Davide-Colabella/solar-tracker/hardware/valve-controller/valves.md

# Elettrovalvole a 5 V

Lo schematico rappresenta **quattro elettrovalvole normalmente chiuse a 5 V DC**, collegate ai morsetti J2–J5. Il riferimento precedente a Bürkert 6011 a 24 V è stato rimosso in base alla correzione dell'alimentazione.

Come richiesto, non è stato selezionato né verificato un modello commerciale. Le valvole devono servire il serbatoio a gravità; i loro ingombri e i raccordi non sono definiti dal PCB.

Il [render](valve-controller-3d.png) mostra la scheda elettronica e i suoi componenti. Il modello STEP si può esportare dall'editor PCB di KiCad. Per rappresentare anche le valvole e i tubi, importare la scheda in FreeCAD e aggiungere quattro istanze del CAD del modello di valvola effettivamente utilizzato.

Le valvole non hanno footprint sulla scheda: J2–J5 rappresentano i morsetti elettrici, non la loro posizione meccanica.
