Davide-Colabella/solar-tracker/docs/assets/solar-garden-user.png

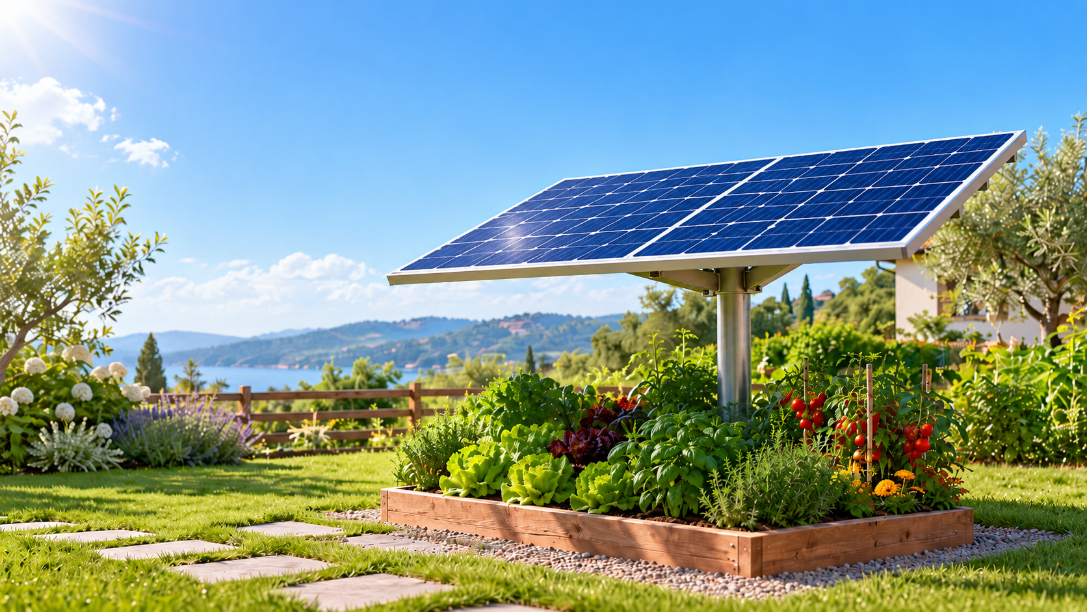
docs/assets/solar-garden-user.png
