Davide-Colabella/solar-tracker/3d models/01_Base_palo.step

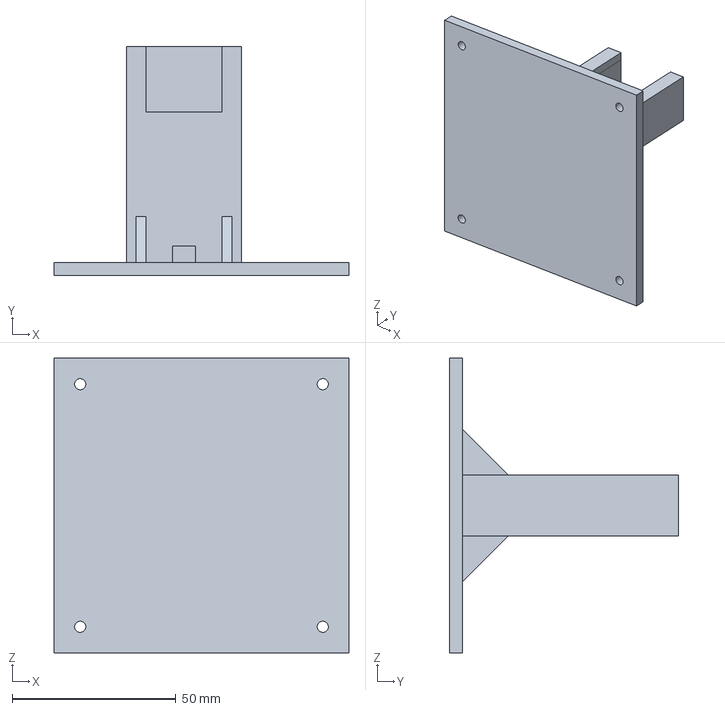
[picture p11: CAD file, 2026-10-11]
3d models/01_Base_palo.step
90.0 x 70.0 x 90.0 mm
