Davide-Colabella/solar-tracker/3d models/scatola2_led_corpo.stl

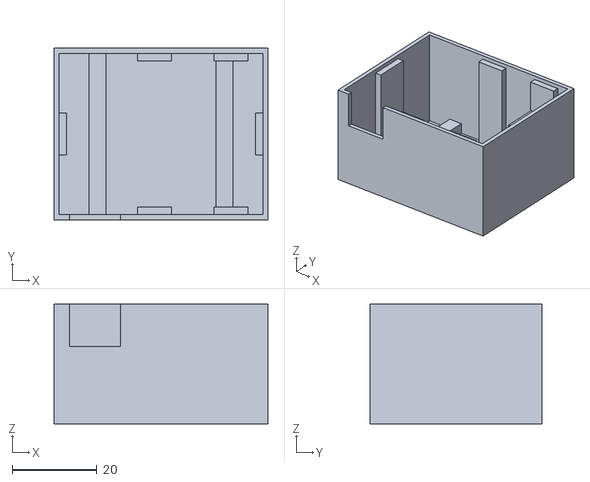
[picture p12: CAD file, 2026-10-11]
3d models/scatola2_led_corpo.stl
50.4 x 40.4 x 28.2
