Davide-Colabella/solar-tracker/3d models/scatola1_arduino_corpo.stl

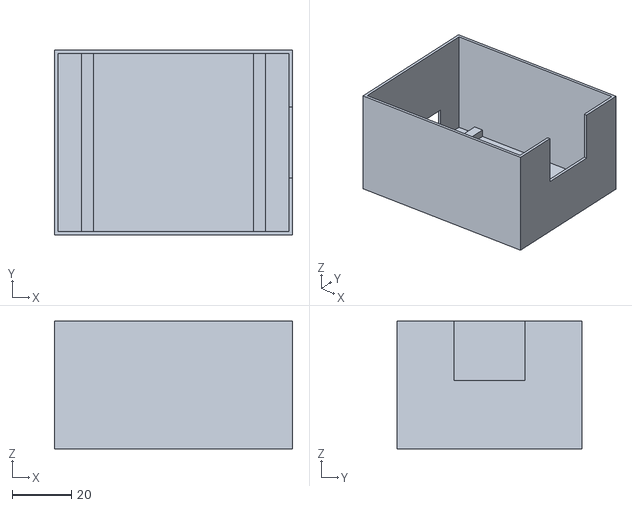
[picture p13: CAD file, 2026-10-11]
3d models/scatola1_arduino_corpo.stl
80.4 x 62.4 x 43.1
