Davide-Colabella/solar-tracker/3d models/03_Telaio_pannello_90x60.step

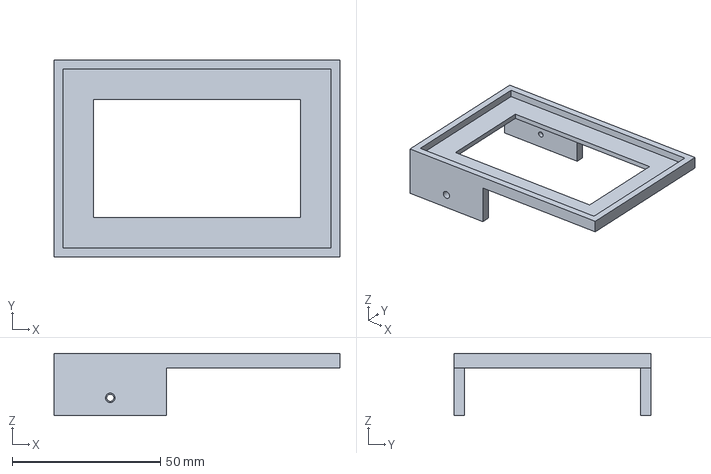
[picture p14: CAD file, 2026-10-11]
3d models/03_Telaio_pannello_90x60.step
96.6 x 66.6 x 21.0 mm
