Davide-Colabella/solar-tracker/3d models/scatola1_arduino_coperchio.stl

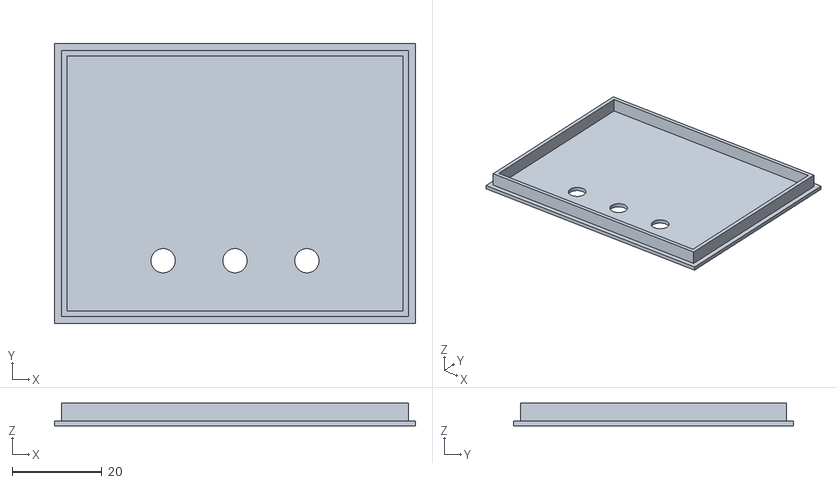
[picture p15: CAD file, 2026-10-11]
3d models/scatola1_arduino_coperchio.stl
80.4 x 62.4 x 5.12
