Davide-Colabella/solar-tracker/3d models/02_Forcella_rotante.step

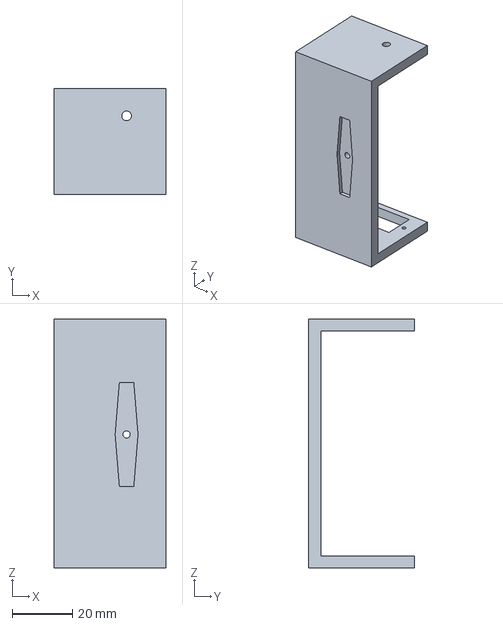
[picture p16: CAD file, 2026-10-11]
3d models/02_Forcella_rotante.step
37.0 x 35.0 x 82.6 mm
