Davide-Colabella/solar-tracker/3d models/scatola2_led_coperchio.stl

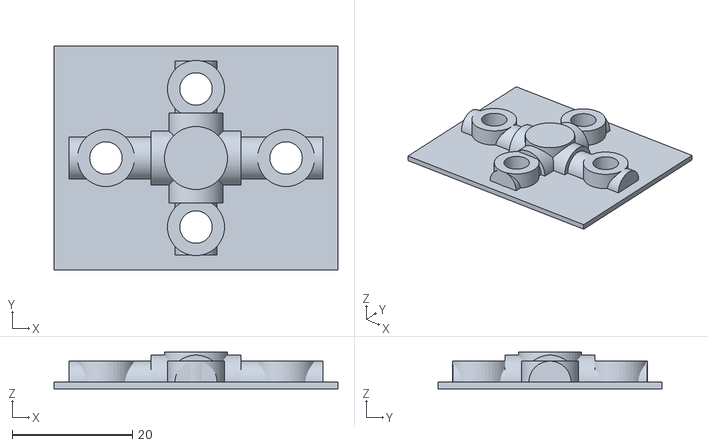
[picture p17: CAD file, 2026-10-11]
3d models/scatola2_led_coperchio.stl
47.3 x 37.3 x 6.12
