Davide-Colabella/solar-tracker/hardware/valve-controller/valve-controller.kicad_pcb

## KiCad design hardware/valve-controller/valve-controller.kicad_pcb (2026-10-11)

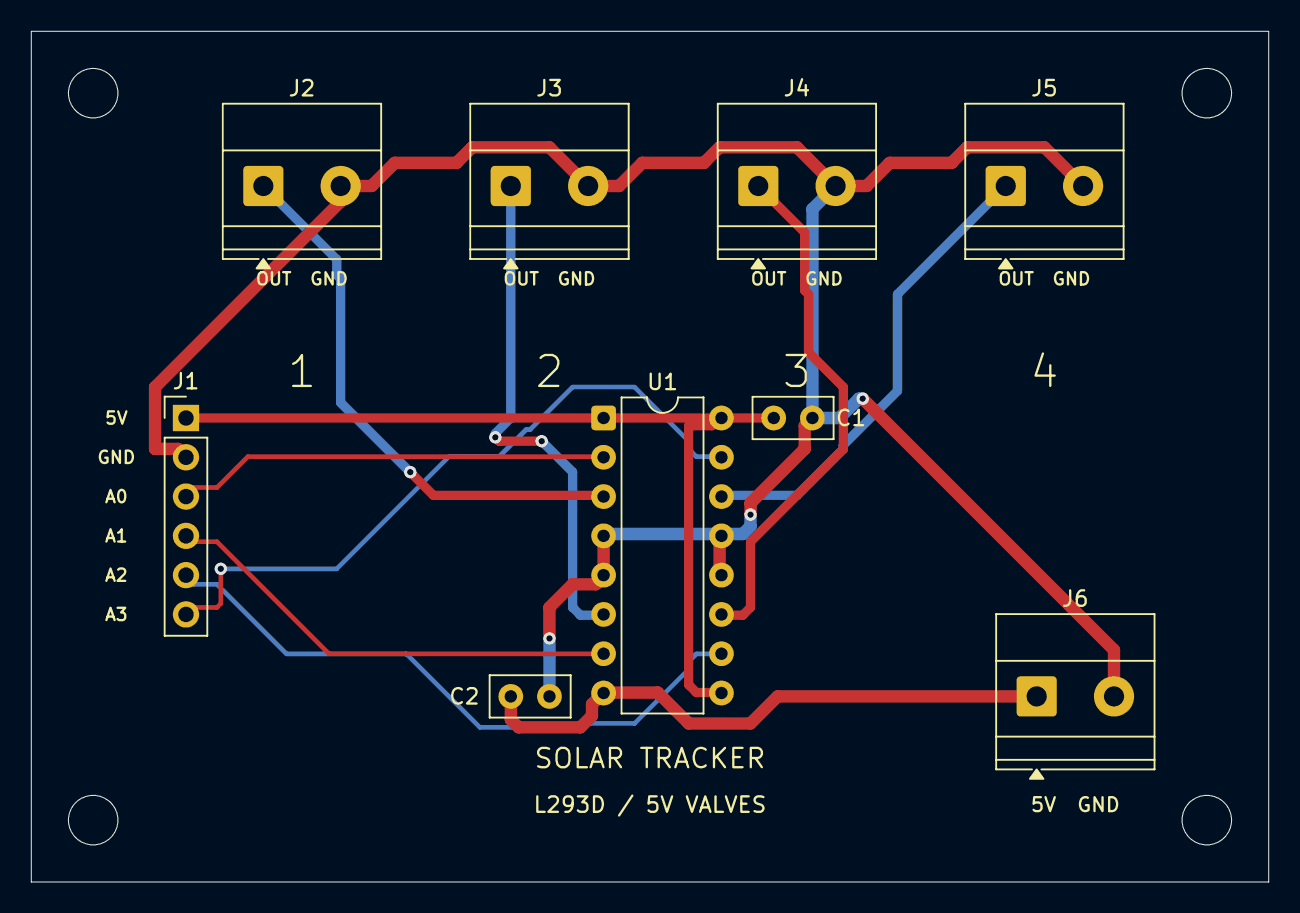
[picture p18: board valve-controller.kicad_pcb from above]

Board: 2 copper layers, 80.0 x 55.0 mm, 13 parts (0 on the bottom side), 11 nets.

Parts:
C1, C2: 100nF; C_Disc_D5.0mm_W2.5mm_P2.50mm
H1, H2, H3, H4: M3; MountingHole_3.2mm_M3
J1: UNO Q; PinHeader_1x06_P2.54mm_Vertical
J2: Valve 1; TerminalBlock_Phoenix_MKDS-1,5-2_1x02_P5.00mm_Horizontal
J3: Valve 2; TerminalBlock_Phoenix_MKDS-1,5-2_1x02_P5.00mm_Horizontal
J4: Valve 3; TerminalBlock_Phoenix_MKDS-1,5-2_1x02_P5.00mm_Horizontal
J5: Valve 4; TerminalBlock_Phoenix_MKDS-1,5-2_1x02_P5.00mm_Horizontal
J6: 5V DC input; TerminalBlock_Phoenix_MKDS-1,5-2_1x02_P5.00mm_Horizontal
U1: L293D; DIP-16_W7.62mm

Connections:
/+5V: C1.1, J1.1, U1.1, U1.9, U1.16
/+5V_VALVES: C2.1, J6.1, U1.8
/A0: J1.3, U1.2
/A1: J1.4, U1.7
/A2: J1.5, U1.10
/A3: J1.6, U1.15
/GND: C1.2, C2.2, J1.2, J2.2, J3.2, J4.2, J5.2, J6.2, U1.4, U1.5, U1.12, U1.13
/OUT1: J2.1, U1.3
/OUT2: J3.1, U1.6
/OUT3: J4.1, U1.11
/OUT4: J5.1, U1.14
