Davide-Colabella/solar-tracker/hardware/ina-panel-monitor/ina-panel-monitor.kicad_pcb

## KiCad design hardware/ina-panel-monitor/ina-panel-monitor.kicad_pcb (2026-10-11)

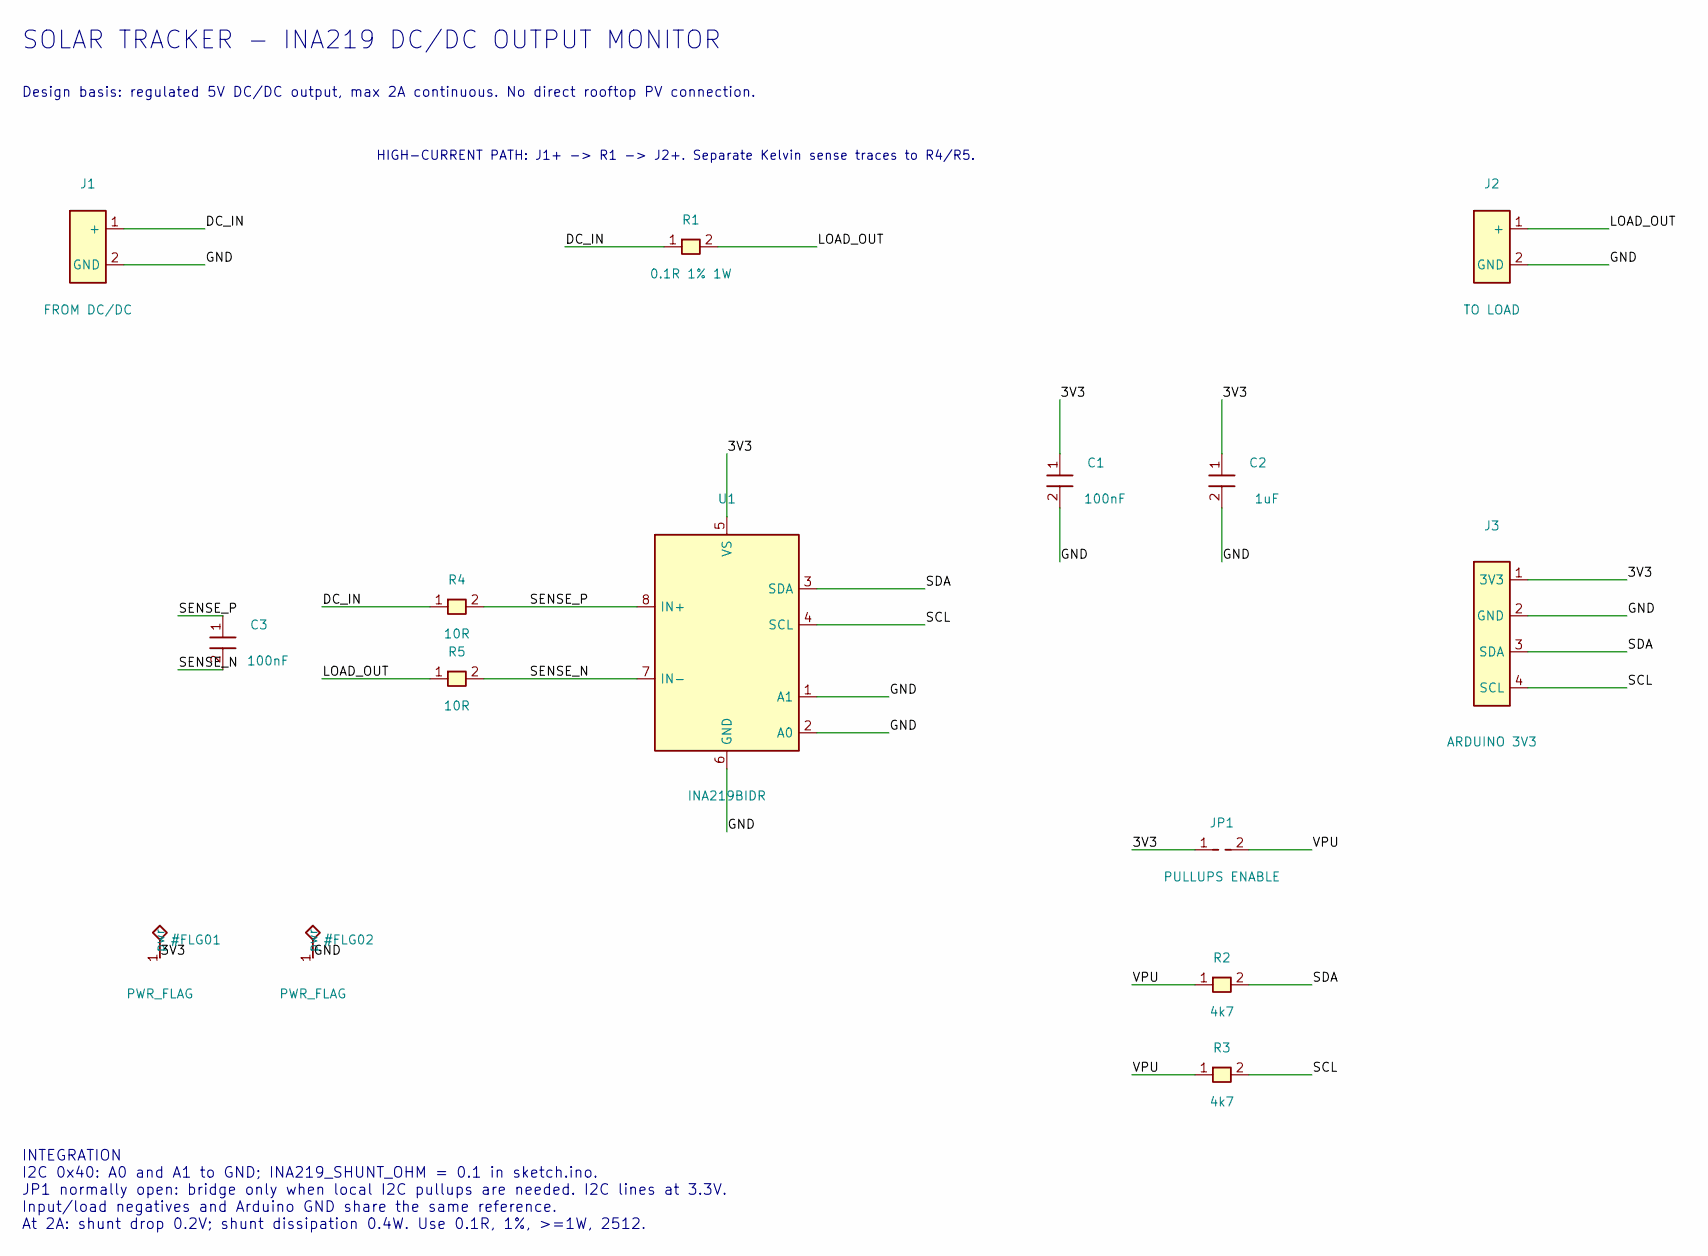
[picture p19: schematic ina-panel-monitor.kicad_sch, Solar Tracker - INA219 panel monitor]

Parts:
C1, C3: 100nF; C_0805_2012Metric
C2: 1uF; C_0805_2012Metric
J1: FROM DC/DC; TerminalBlock_Phoenix_MKDS-1,5-2_1x02_P5.00mm_Horizontal
J2: TO LOAD; TerminalBlock_Phoenix_MKDS-1,5-2_1x02_P5.00mm_Horizontal
J3: ARDUINO 3V3; PinHeader_1x04_P2.54mm_Vertical
JP1: PULLUPS ENABLE; SolderJumper-2_P1.3mm_Open_Pad1.0x1.5mm
R1: 0.1R 1% 1W; R_2512_6332Metric
R2, R3: 4k7; R_0603_1608Metric
R4, R5: 10R; R_0603_1608Metric
U1: INA219BIDR; SOIC-8_3.9x4.9mm_P1.27mm

Connections:
/3V3: C1.1, C2.1, J3.1 (3V3), JP1.1, U1.5 (VS)
/DC_IN: J1.1 (+), R1.1, R4.1
/GND: C1.2, C2.2, J1.2 (GND), J2.2 (GND), J3.2 (GND), U1.1 (A1), U1.2 (A0), U1.6 (GND)
/LOAD_OUT: J2.1 (+), R1.2, R5.1
/SCL: J3.4 (SCL), R3.2, U1.4 (SCL)
/SDA: J3.3 (SDA), R2.2, U1.3 (SDA)
/SENSE_N: C3.2, R5.2, U1.7 (IN-)
/SENSE_P: C3.1, R4.2, U1.8 (IN+)
/VPU: JP1.2, R2.1, R3.1

Notes on the sheet:
SOLAR TRACKER - INA219 DC/DC OUTPUT MONITOR
Design basis: regulated 5V DC/DC output, max 2A continuous. No direct rooftop PV connection.
HIGH-CURRENT PATH: J1+ -> R1 -> J2+. Separate Kelvin sense traces to R4/R5.
INTEGRATION I2C 0x40: A0 and A1 to GND; INA219_SHUNT_OHM = 0.1 in sketch.ino. JP1 normally open: bridge only when local I2C pullups are needed. I2C lines at 3.3V. Input/load negatives and Arduino GND share the same reference. At 2A: shunt drop 0.2V; shunt dissipation 0.4W. Use 0.1R, 1%, >=1W, 2512.

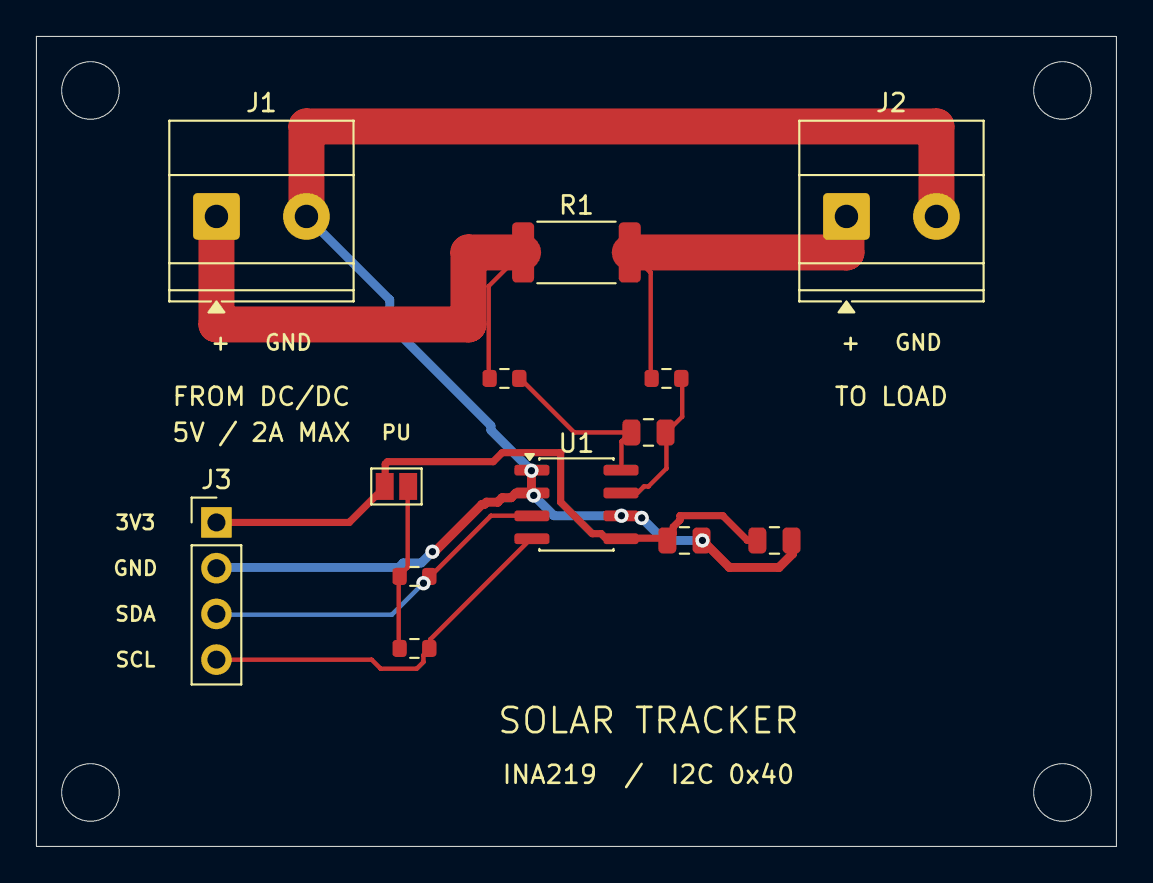
[picture p20: board ina-panel-monitor.kicad_pcb from above]

Board: 2 copper layers, 60.0 x 45.0 mm, 17 parts (0 on the bottom side), 9 nets.

Other parts of the board:
H1, H2, H3, H4: M3; MountingHole_3.2mm_M3
