Davide-Colabella/solar-tracker/(commit log)

2026-10-11 Inseguitore solare con cura della pianta per Arduino UNO Q
    App per Arduino App Lab: sketch per il microcontrollore, logica in Python,
    pagina web con tema scuro e prova dei componenti, modelli ONNX per
    riconoscere la pianta e il suo stato.
    Claude-Session: https://claude.ai/code/session_01NE64qPCxQUtJv1UHZeYHi1
2026-10-11 Inseguitore solare con cura della pianta per Arduino UNO Q
    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
2026-10-11 Scambia i pin di LED e valvole
    LED spostati da A0/A1 a D6/D7, linee valvola 1-2 da D6/D7 a A0/A1. Aggiornati sketch, README e pagina web.
2026-10-11 Secondo servo, nuova piedinatura, modelli 3D e README aggiornato
    - Servo azimut su D9 (timer TIM4); AHT20 della pianta sulla porta D4 (I2C software D4/D5); LED stato su D8; LED azimut tolto.
    - Pitch invertito (PITCH_SERVO_REVERSED) e tolto dalla prova di avvio.
    - I comandi della pagina svegliano subito il ciclo Python.
    - Modelli 3D del supporto e delle scatole con i render; README con tecnologie, collegamenti e modelli.
    [01_Base_palo.step, 02_Forcella_rotante.step, 03_Telaio_pannello_90x60.step, scatola1_arduino_coperchio.stl, scatola1_arduino_corpo.stl, scatola2_led_coperchio.stl, scatola2_led_corpo.stl]
2026-10-11 Secondo servo, corsa del pitch tarata, modelli 3D e README aggiornato
    - Pitch invertito (PITCH_SERVO_REVERSED), tolto dalla prova di avvio, corsa tarata 0-135 gradi (0 = parallelo alla base).
    - I comandi della pagina svegliano subito il ciclo Python; cursore del pitch limitato a 0-135.
    - Modelli 3D del supporto e delle scatole con i render.
    - README: tecnologie usate, collegamenti, configurazione e modelli 3D.
    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
2026-10-11 Pitch tarato 65-150 (135 = in piano) e servo segnato come montato
    - Corsa del pitch 65-150 nello sketch; lato Python con piano a 135, direzione -1, inclinazione da -15 a 70 gradi.
    - Pagina di prova: cursore e pulsanti del pitch dentro la corsa.
    - Prove adattate alla nuova corsa.
    - README: corsa aggiornata, tolto il servo dai componenti simulati.
2026-10-11 Add valve and INA PCBs with renders in the project README
    [ina-panel-monitor.kicad_pcb, ina-panel-monitor.kicad_sch, valve-controller.kicad_pcb, valve-controller.kicad_sch]
2026-10-11 Rename valve board render and update documentation links
2026-10-11 Sezione Le mie piante (mockup) con stato dai sensori e prossima innaffiatura stimata
    - GARDEN in config.py: una pianta per linea.
    - garden_plan in irrigation.py: luce, temperatura e acqua dai sensori montati; prossima innaffiatura con le regole dell'irrigazione (dose per linea, pausa minima, fuori dalle ore calde, serbatoio).
    - demand_factor estratto e usato anche dal bilancio idrico.
    - Pagina: una scheda per pianta. README e prova aggiornati.
2026-10-11 Add COESA Solar Tracker landing page for GitHub Pages
2026-10-11 Update landing page pricing from HackTurin economic analysis
2026-10-11 Refresh cached landing page assets after pricing update
